karaketir16/NUC980DKxxYx_Development_Board/MPU.kicad_sch

## KiCad design MPU.kicad_sch (2023-03-14)

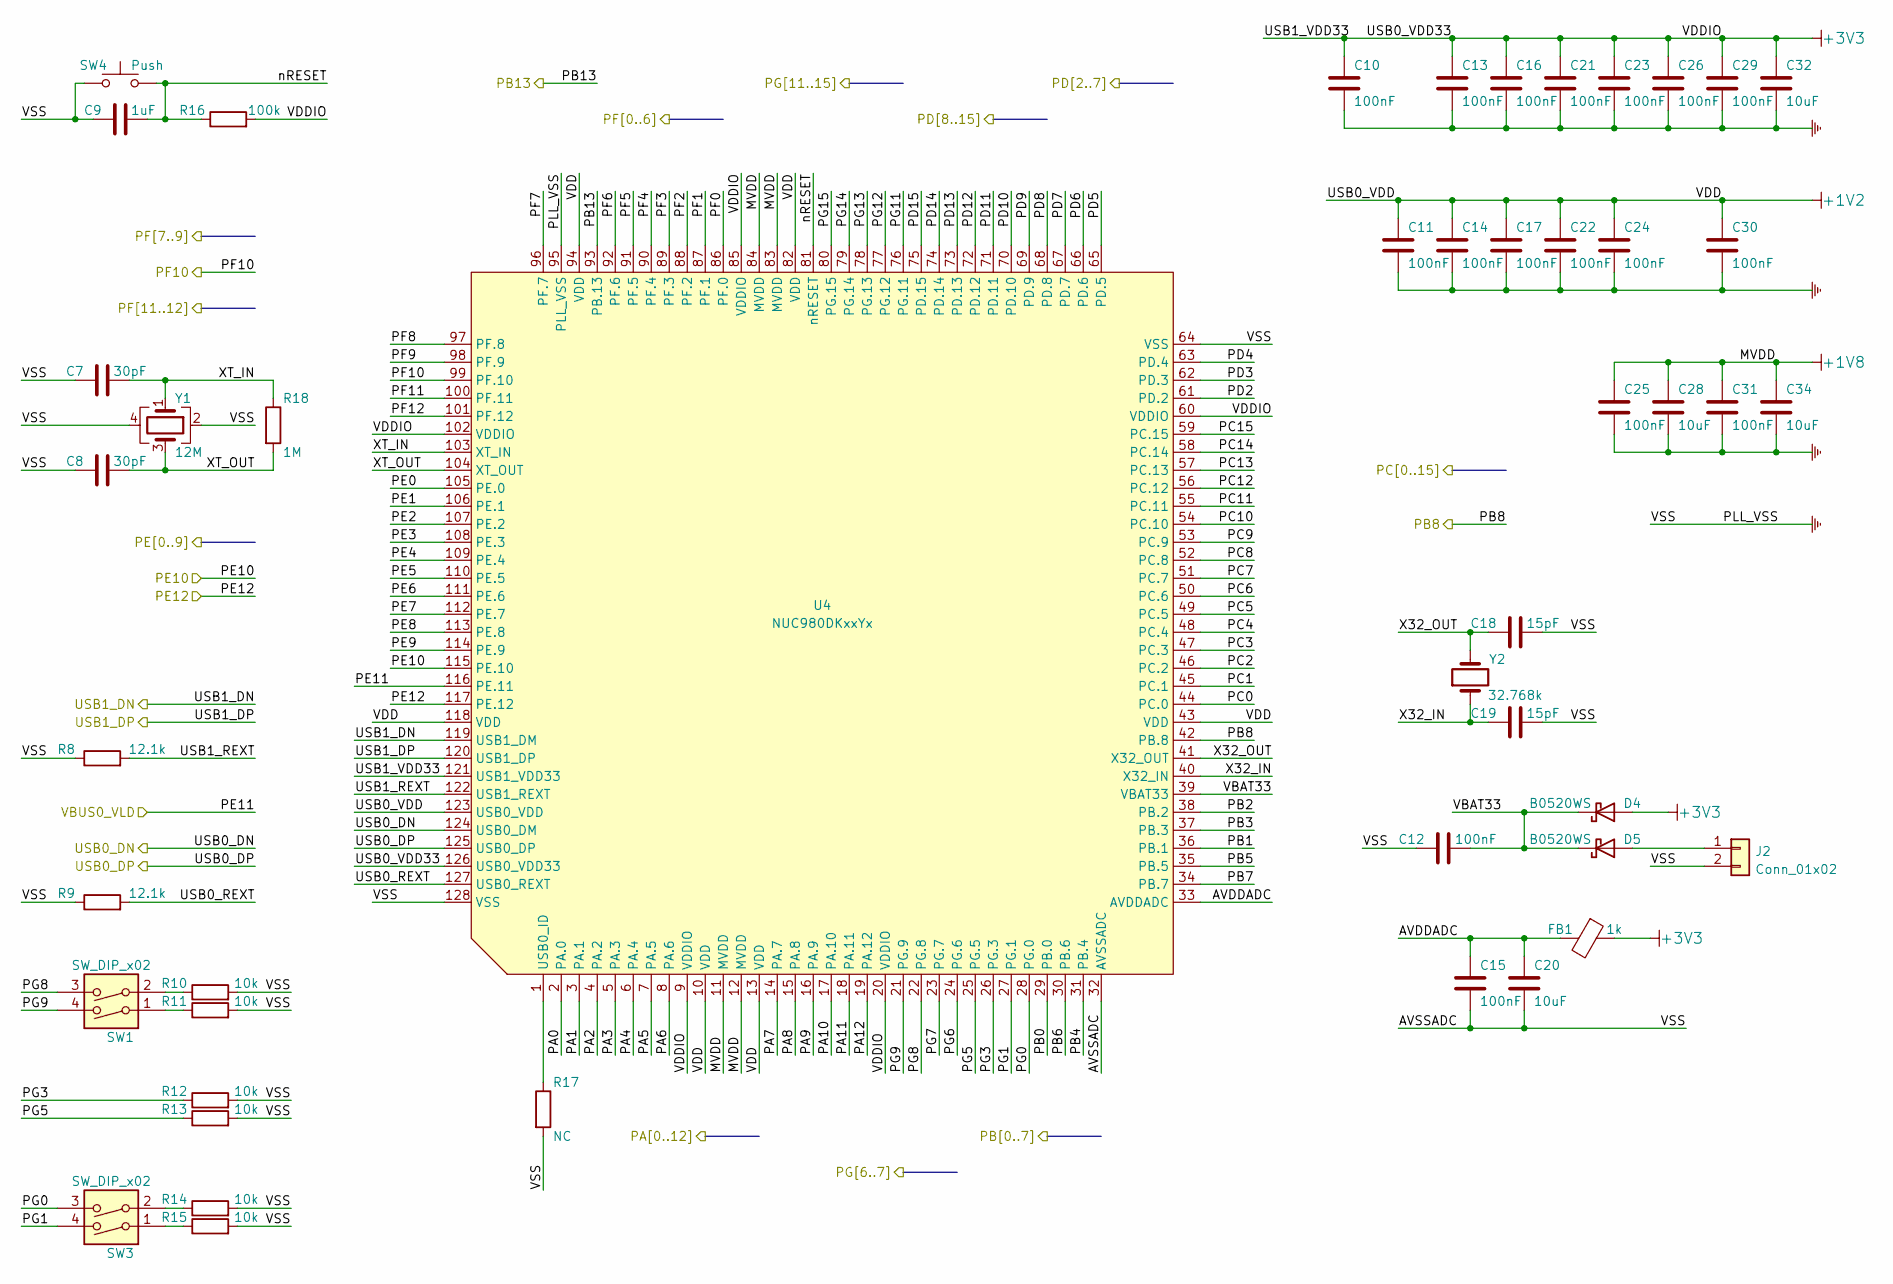
[picture p1: schematic MPU.kicad_sch]

Parts:
C7, C8: 30pF; C_0805_2012Metric_Pad1.18x1.45mm_HandSolder
C9: 1uF; C_0805_2012Metric_Pad1.18x1.45mm_HandSolder
C10, C11, C12, C13, C14, C15, C16, C17, C21, C22, C23, C24, C25, C26, C29, C30, C31: 100nF; C_0805_2012Metric_Pad1.18x1.45mm_HandSolder
C18, C19: 15pF; C_0805_2012Metric_Pad1.18x1.45mm_HandSolder
C20, C28, C32, C34: 10uF; C_0805_2012Metric_Pad1.18x1.45mm_HandSolder
D4, D5: B0520WS; D_SOD-323
FB1: 1k; L_0603_1608Metric
J2: Conn_01x02; PinHeader_1x02_P2.54mm_Vertical
R8, R9: 12.1k; R_0805_2012Metric_Pad1.20x1.40mm_HandSolder
R10, R11, R12, R13, R14, R15: 10k; R_0805_2012Metric_Pad1.20x1.40mm_HandSolder
R16: 100k; R_0805_2012Metric_Pad1.20x1.40mm_HandSolder
R17: NC; R_0805_2012Metric_Pad1.20x1.40mm_HandSolder
R18: 1M; R_0805_2012Metric_Pad1.20x1.40mm_HandSolder
SW1, SW3: SW_DIP_x02; SW_DIP_SPSTx02_Slide_9.78x7.26mm_W7.62mm_P2.54mm
SW4: Push; SW_SPST_CK_RS282G05A3
U4: NUC980DKxxYx; LQFP-128_14x14mm_P0.4mm
Y1: 12M; Crystal_SMD_3225-4Pin_3.2x2.5mm
Y2: 32.768k; Crystal_SMD_3215-2Pin_3.2x1.5mm

Connections:
+1V2: C11.1, C14.1, C17.1, C22.1, C24.1, C30.1, U4.10 (VDD), U4.13 (VDD), U4.43 (VDD), U4.82 (VDD), U4.94 (VDD), U4.118 (VDD), U4.123 (USB0_VDD)
+1V8: C25.1, C28.1, C31.1, C34.1, U4.11 (MVDD), U4.12 (MVDD), U4.83 (MVDD), U4.84 (MVDD)
+3V3: C10.1, C13.1, C16.1, C21.1, C23.1, C26.1, C29.1, C32.1, D4.2 (A), FB1.1, R16.2, U4.9 (VDDIO), U4.20 (VDDIO), U4.60 (VDDIO), U4.85 (VDDIO), U4.102 (VDDIO), U4.121 (USB1_VDD33), U4.126 (USB0_VDD33)
AVDDADC: C15.1, C20.1, FB1.2, U4.33 (AVDDADC)
GND: C7.1, C8.1, C9.1, C10.2, C11.2, C12.1, C13.2, C14.2, C15.2, C16.2, C17.2, C18.2, C19.2, C20.2, C21.2, C22.2, C23.2, C24.2, C25.2, C26.2, C28.2, C29.2, C30.2, C31.2, C32.2, C34.2, J2.2, R8.1, R9.1, R10.2, R11.2, R12.2, R13.2, R14.2, R15.2, R17.2, SW4.2, U4.32 (AVSSADC), U4.64 (VSS), U4.95 (PLL_VSS), U4.128 (VSS), Y1.2, Y1.4
unnamed: D5.2 (A), J2.1
unnamed: R10.1, SW1.2
unnamed: R11.1, SW1.1
unnamed: R14.1, SW3.2
unnamed: R15.1, SW3.1
unnamed: R17.1, U4.1 (USB0_ID)
PA0: U4.2 (PA.0)
PA1: U4.3 (PA.1)
PA2: U4.4 (PA.2)
PA3: U4.5 (PA.3)
PA4: U4.6 (PA.4)
PA5: U4.7 (PA.5)
PA6: U4.8 (PA.6)
PA7: U4.14 (PA.7)
PA8: U4.15 (PA.8)
PA9: U4.16 (PA.9)
PA10: U4.17 (PA.10)
PA11: U4.18 (PA.11)
PA12: U4.19 (PA.12)
PB0: U4.29 (PB.0)
PB1: U4.36 (PB.1)
PB2: U4.38 (PB.2)
PB3: U4.37 (PB.3)
PB4: U4.31 (PB.4)
PB5: U4.35 (PB.5)
PB6: U4.30 (PB.6)
PB7: U4.34 (PB.7)
PB8: U4.42 (PB.8)
PB13: U4.93 (PB.13)
PC0: U4.44 (PC.0)
PC1: U4.45 (PC.1)
PC2: U4.46 (PC.2)
PC3: U4.47 (PC.3)
PC4: U4.48 (PC.4)
PC5: U4.49 (PC.5)
PC6: U4.50 (PC.6)
PC7: U4.51 (PC.7)
PC8: U4.52 (PC.8)
PC9: U4.53 (PC.9)
PC10: U4.54 (PC.10)
PC11: U4.55 (PC.11)
PC12: U4.56 (PC.12)
PC13: U4.57 (PC.13)
PC14: U4.58 (PC.14)
PC15: U4.59 (PC.15)
PD2: U4.61 (PD.2)
PD3: U4.62 (PD.3)
PD4: U4.63 (PD.4)
PD5: U4.65 (PD.5)
PD6: U4.66 (PD.6)
PD7: U4.67 (PD.7)
PD8: U4.68 (PD.8)
PD9: U4.69 (PD.9)
PD10: U4.70 (PD.10)
PD11: U4.71 (PD.11)
PD12: U4.72 (PD.12)
PD13: U4.73 (PD.13)
PD14: U4.74 (PD.14)
PD15: U4.75 (PD.15)
PE0: U4.105 (PE.0)
PE1: U4.106 (PE.1)
PE2: U4.107 (PE.2)
PE3: U4.108 (PE.3)
PE4: U4.109 (PE.4)
PE5: U4.110 (PE.5)
PE6: U4.111 (PE.6)
PE7: U4.112 (PE.7)
PE8: U4.113 (PE.8)
PE9: U4.114 (PE.9)
PE10: U4.115 (PE.10)
PE11: U4.116 (PE.11)
PE12: U4.117 (PE.12)
PF0: U4.86 (PF.0)
PF1: U4.87 (PF.1)
PF2: U4.88 (PF.2)
PF3: U4.89 (PF.3)
PF4: U4.90 (PF.4)
PF5: U4.91 (PF.5)
PF6: U4.92 (PF.6)
PF7: U4.96 (PF.7)
PF8: U4.97 (PF.8)
PF9: U4.98 (PF.9)
PF10: U4.99 (PF.10)
PF11: U4.100 (PF.11)
PF12: U4.101 (PF.12)
PG0: SW3.3, U4.28 (PG.0)
PG1: SW3.4, U4.27 (PG.1)
PG3: R12.1, U4.26 (PG.3)
PG5: R13.1, U4.25 (PG.5)
PG6: U4.24 (PG.6)
PG7: U4.23 (PG.7)
PG8: SW1.3, U4.22 (PG.8)
PG9: SW1.4, U4.21 (PG.9)
PG11: U4.76 (PG.11)
PG12: U4.77 (PG.12)
PG13: U4.78 (PG.13)
PG14: U4.79 (PG.14)
PG15: U4.80 (PG.15)
USB0_DN: U4.124 (USB0_DM)
USB0_DP: U4.125 (USB0_DP)
USB0_REXT: R9.2, U4.127 (USB0_REXT)
USB1_DN: U4.119 (USB1_DM)
USB1_DP: U4.120 (USB1_DP)
USB1_REXT: R8.2, U4.122 (USB1_REXT)
VBAT33: C12.2, D4.1 (K), D5.1 (K), U4.39 (VBAT33)
X32_IN: C19.1, U4.40 (X32_IN), Y2.1
X32_OUT: C18.1, U4.41 (X32_OUT), Y2.2
XT_IN: C7.2, R18.1, U4.103 (XT_IN), Y1.1
XT_OUT: C8.2, R18.2, U4.104 (XT_OUT), Y1.3
nRESET: C9.2, R16.1, SW4.1, U4.81 (nRESET)
