karaketir16/NUC980DKxxYx_Development_Board/Power.kicad_sch

## KiCad design Power.kicad_sch (2023-03-14)

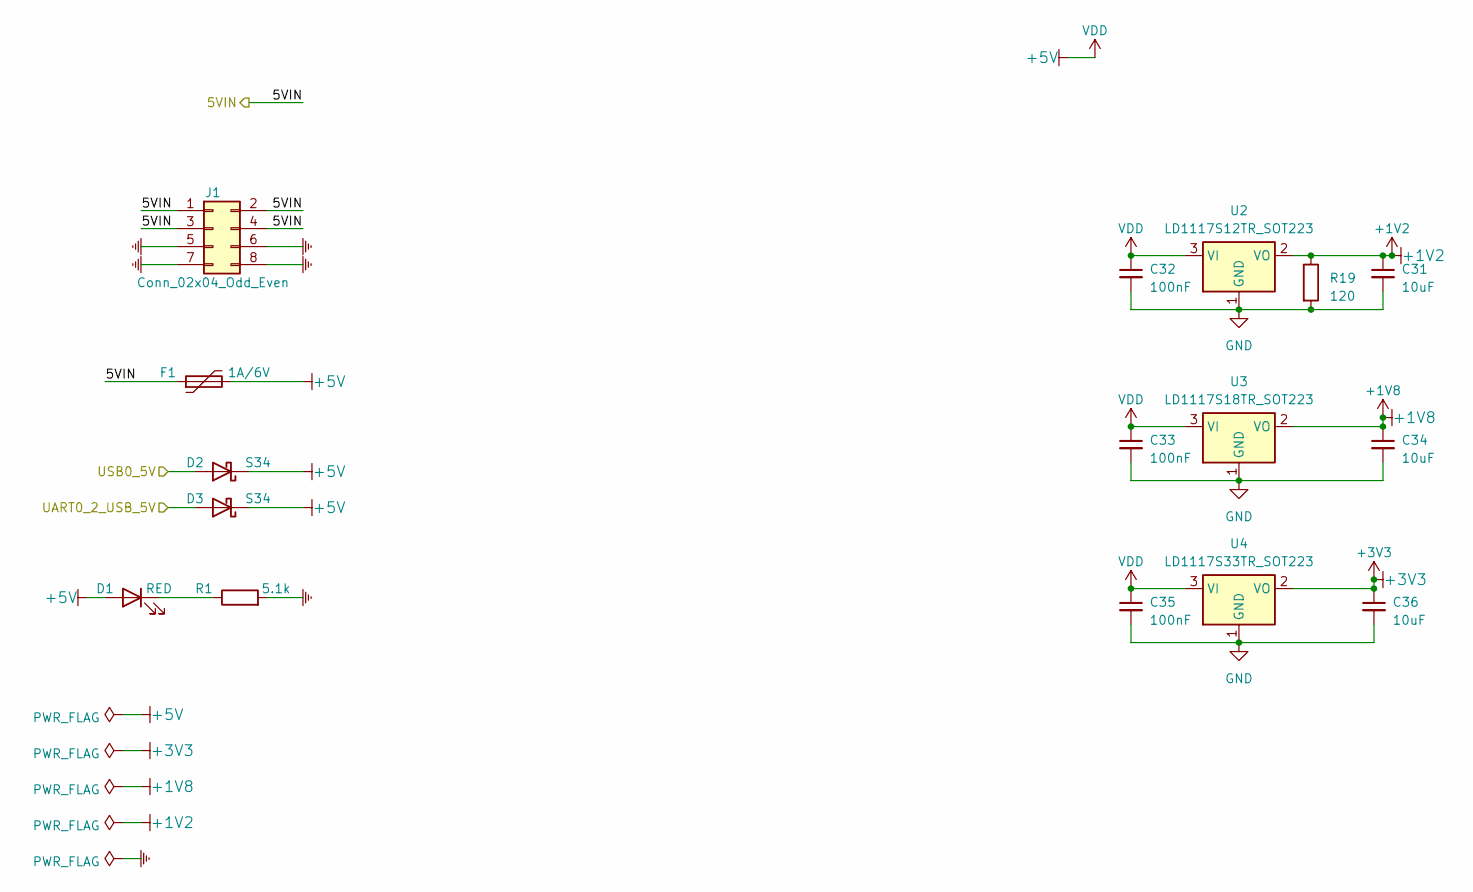
[picture p2: schematic Power.kicad_sch]

Parts:
C31, C34, C36: 10uF; C_0603_1608Metric_Pad1.08x0.95mm_HandSolder
C32, C33, C35: 100nF; C_0603_1608Metric_Pad1.08x0.95mm_HandSolder
D1: RED; LED_0603_1608Metric
D2, D3: S34; D_SOD-123F
F1: 1A/6V; Fuse_1206_3216Metric_Pad1.42x1.75mm_HandSolder
J1: Conn_02x04_Odd_Even; PinHeader_2x04_P2.54mm_Vertical
R1: 5.1k; R_0805_2012Metric_Pad1.20x1.40mm_HandSolder
R19: 120; R_0603_1608Metric_Pad0.98x0.95mm_HandSolder
U2: LD1117S12TR_SOT223; SOT-223-3_TabPin2
U3: LD1117S18TR_SOT223; SOT-223-3_TabPin2
U4: LD1117S33TR_SOT223; SOT-223-3_TabPin2

Connections:
5VIN: F1.1, J1.1, J1.2, J1.3, J1.4
+1V2: C31.1, R19.1, U2.2 (VO)
+1V8: C34.1, U3.2 (VO)
+3V3: C36.1, U4.2 (VO)
+5V: C32.1, C33.1, C35.1, D1.2 (A), D2.1 (K), D3.1 (K), F1.2, U2.3 (VI), U3.3 (VI), U4.3 (VI)
GND: C31.2, C32.2, C33.2, C34.2, C35.2, C36.2, J1.5, J1.6, J1.7, J1.8, R1.2, R19.2, U2.1 (GND), U3.1 (GND), U4.1 (GND)
unnamed: D1.1 (K), R1.1
UART0_2_USB_5V: D3.2 (A)
USB0_5V: D2.2 (A)
