karaketir16/NUC980DKxxYx_Development_Board/RMII_ETH.kicad_sch

## KiCad design RMII_ETH.kicad_sch (2023-03-14)

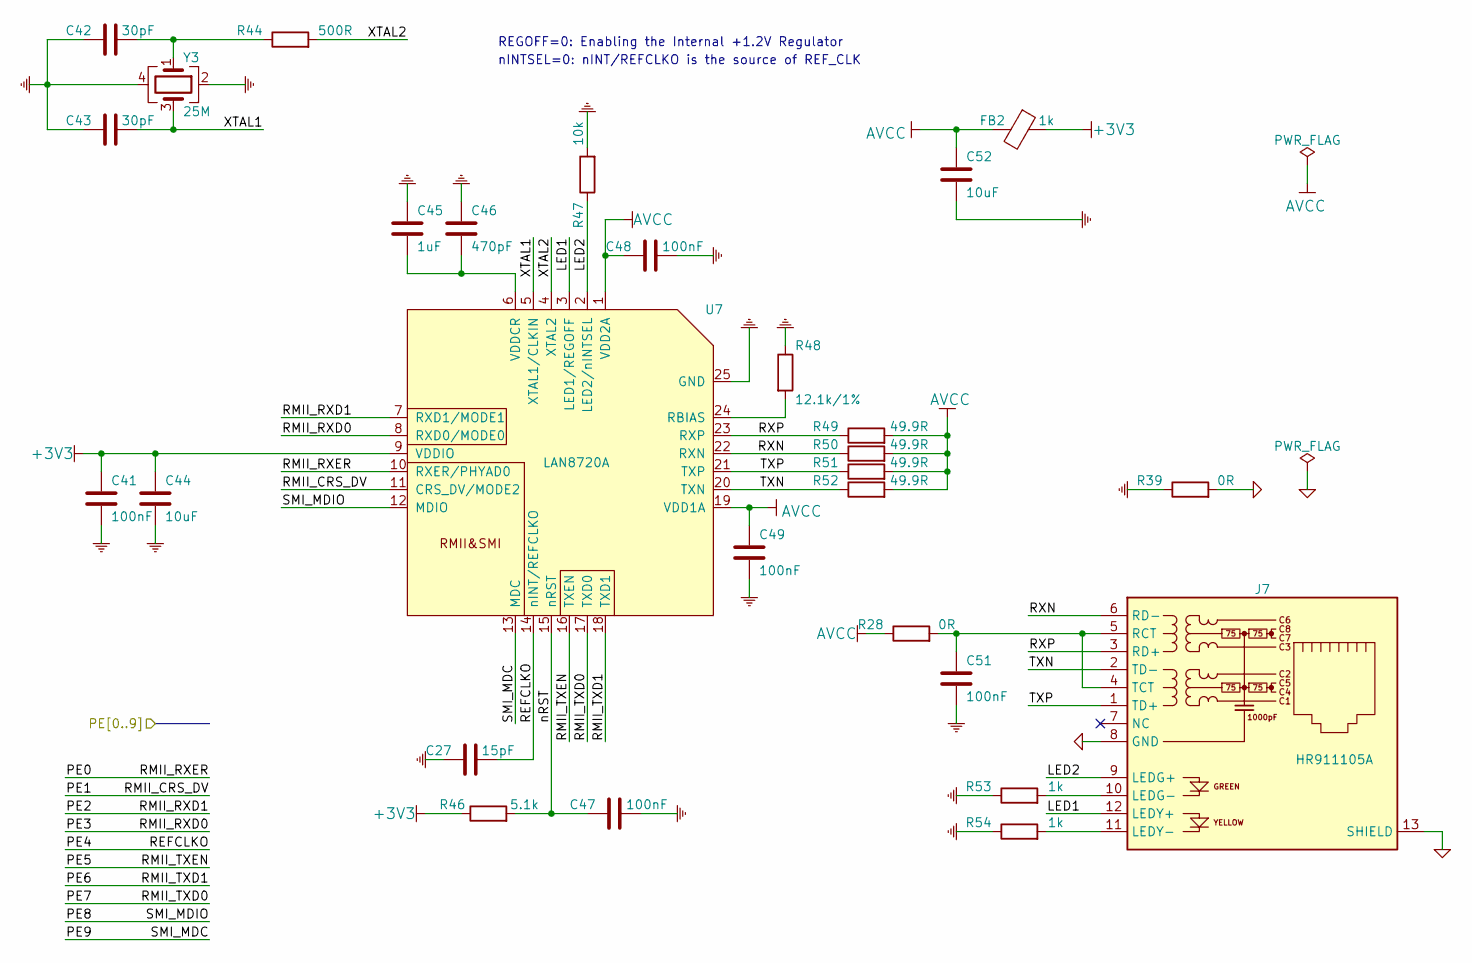
[picture p3: schematic RMII_ETH.kicad_sch]

Parts:
C27: 15pF; C_0805_2012Metric_Pad1.18x1.45mm_HandSolder
C41, C47, C48, C49, C51: 100nF; C_0805_2012Metric_Pad1.18x1.45mm_HandSolder
C42, C43: 30pF; C_0805_2012Metric_Pad1.18x1.45mm_HandSolder
C44, C52: 10uF; C_0805_2012Metric_Pad1.18x1.45mm_HandSolder
C45: 1uF; C_0805_2012Metric_Pad1.18x1.45mm_HandSolder
C46: 470pF; C_0805_2012Metric_Pad1.18x1.45mm_HandSolder
FB2: 1k; L_0603_1608Metric
J7: HR911105A; RJ45_Hanrun_HR911105A
R28, R39: 0R; R_0805_2012Metric_Pad1.20x1.40mm_HandSolder
R44: 500R; R_0805_2012Metric_Pad1.20x1.40mm_HandSolder
R46: 5.1k; R_0805_2012Metric_Pad1.20x1.40mm_HandSolder
R47: 10k; R_0805_2012Metric_Pad1.20x1.40mm_HandSolder
R48: 12.1k/1%; R_0805_2012Metric_Pad1.20x1.40mm_HandSolder
R49, R50, R51, R52: 49.9R; R_0805_2012Metric_Pad1.20x1.40mm_HandSolder
R53, R54: 1k; R_0805_2012Metric_Pad1.20x1.40mm_HandSolder
U7: LAN8720A; VQFN-24-1EP_4x4mm_P0.5mm_EP2.45x2.45mm
Y3: 25M; Crystal_SMD_3225-4Pin_3.2x2.5mm

Connections:
+3V3: C41.1, C44.1, FB2.1, R46.1, U7.9 (VDDIO)
AVCC: C48.1, C49.1, C52.1, FB2.2, R28.1, R49.2, R50.2, R51.2, R52.2, U7.1 (VDD2A), U7.19 (VDD1A)
GND: C27.1, C41.2, C42.1, C43.1, C44.2, C45.1, C46.1, C47.2, C48.2, C49.2, C51.2, C52.2, R39.1, R47.2, R48.1, R53.1, R54.1, U7.25 (GND), Y3.2, Y3.4
GNDA: J7.8 (GND), J7.13 (SHIELD), R39.2
LED1: J7.12 (LEDY+), U7.3 (LED1/REGOFF)
LED2: J7.9 (LEDG+), R47.1, U7.2 (LED2/nINTSEL)
unnamed: C42.2, R44.1, Y3.1
unnamed: C45.2, C46.2, U7.6 (VDDCR)
unnamed: C51.1, J7.4 (TCT), J7.5 (RCT), R28.2
unnamed: J7.10 (LEDG-), R53.2
unnamed: J7.11 (LEDY-), R54.2
unnamed: R48.2, U7.24 (RBIAS)
PE0: U7.10 (RXER/PHYAD0)
PE1: U7.11 (CRS_DV/MODE2)
PE2: U7.7 (RXD1/MODE1)
PE3: U7.8 (RXD0/MODE0)
PE4: C27.2, U7.14 (nINT/REFCLKO)
PE5: U7.16 (TXEN)
PE6: U7.18 (TXD1)
PE7: U7.17 (TXD0)
PE8: U7.12 (MDIO)
PE9: U7.13 (MDC)
RXN: J7.6 (RD-), R50.1, U7.22 (RXN)
RXP: J7.3 (RD+), R49.1, U7.23 (RXP)
TXN: J7.2 (TD-), R52.1, U7.20 (TXN)
TXP: J7.1 (TD+), R51.1, U7.21 (TXP)
XTAL1: C43.2, U7.5 (XTAL1/CLKIN), Y3.3
XTAL2: R44.2, U7.4 (XTAL2)
nRST: C47.1, R46.2, U7.15 (nRST)

Notes on the sheet:
REGOFF=0: Enabling the Internal +1.2V Regulator
nINTSEL=0: nINT/REFCLKO is the source of REF_CLK
