karaketir16/NUC980DKxxYx_Development_Board/Remaining_IO.kicad_sch

## KiCad design Remaining_IO.kicad_sch (2023-03-14)

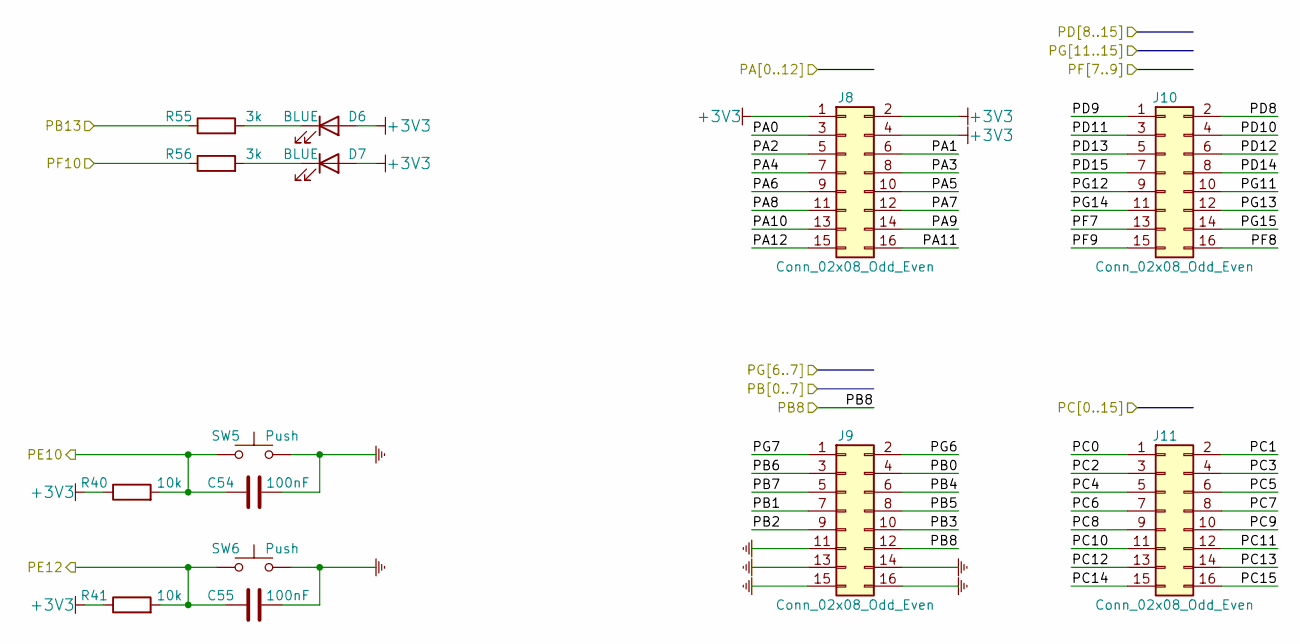
[picture p4: schematic Remaining_IO.kicad_sch]

Parts:
C54, C55: 100nF; C_0805_2012Metric_Pad1.18x1.45mm_HandSolder
D6, D7: BLUE; LED_0603_1608Metric
J8, J9, J10, J11: Conn_02x08_Odd_Even; PinHeader_2x08_P2.54mm_Vertical
R40, R41: 10k; R_0805_2012Metric_Pad1.20x1.40mm_HandSolder
R55, R56: 3k; R_0805_2012Metric_Pad1.20x1.40mm_HandSolder
SW5, SW6: Push; SW_SPST_CK_RS282G05A3

Connections:
+3V3: D6.2 (A), D7.2 (A), J8.1, J8.2, J8.4, R40.1, R41.1
GND: C54.2, C55.2, J9.11, J9.13, J9.14, J9.15, J9.16, SW5.1, SW6.1
unnamed: D6.1 (K), R55.2
unnamed: D7.1 (K), R56.2
PA0: J8.3
PA1: J8.6
PA2: J8.5
PA3: J8.8
PA4: J8.7
PA5: J8.10
PA6: J8.9
PA7: J8.12
PA8: J8.11
PA9: J8.14
PA10: J8.13
PA11: J8.16
PA12: J8.15
PB0: J9.4
PB1: J9.7
PB2: J9.9
PB3: J9.10
PB4: J9.6
PB5: J9.8
PB6: J9.3
PB7: J9.5
PB8: J9.12
PB13: R55.1
PC0: J11.1
PC1: J11.2
PC2: J11.3
PC3: J11.4
PC4: J11.5
PC5: J11.6
PC6: J11.7
PC7: J11.8
PC8: J11.9
PC9: J11.10
PC10: J11.11
PC11: J11.12
PC12: J11.13
PC13: J11.14
PC14: J11.15
PC15: J11.16
PD8: J10.2
PD9: J10.1
PD10: J10.4
PD11: J10.3
PD12: J10.6
PD13: J10.5
PD14: J10.8
PD15: J10.7
PE10: C54.1, R40.2, SW5.2
PE12: C55.1, R41.2, SW6.2
PF7: J10.13
PF8: J10.16
PF9: J10.15
PF10: R56.1
PG6: J9.2
PG7: J9.1
PG11: J10.10
PG12: J10.9
PG13: J10.12
PG14: J10.11
PG15: J10.14
