karaketir16/NUC980DKxxYx_Development_Board/SD_Card.kicad_sch

## KiCad design SD_Card.kicad_sch (2023-03-14)

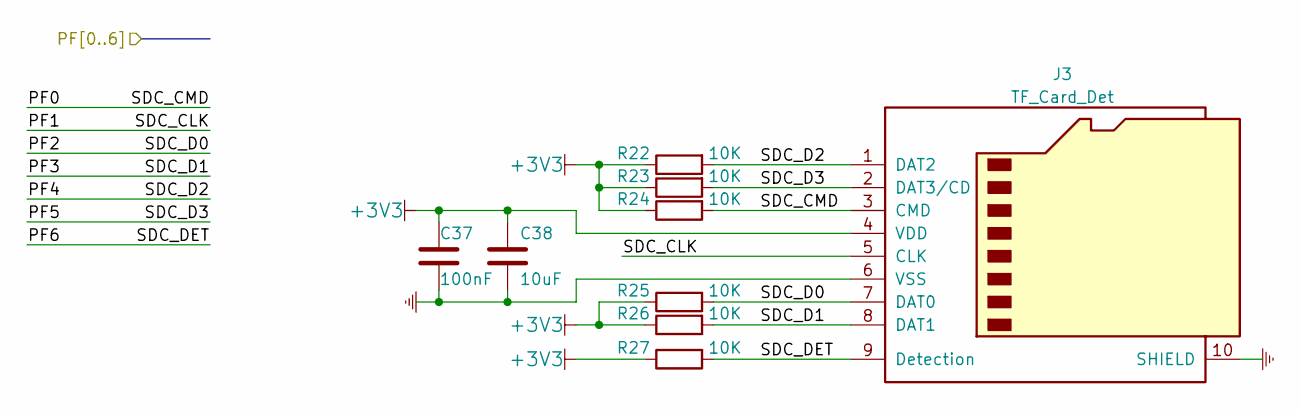
[picture p5: schematic SD_Card.kicad_sch]

Parts:
C37: 100nF; C_0805_2012Metric_Pad1.18x1.45mm_HandSolder
C38: 10uF; C_0805_2012Metric_Pad1.18x1.45mm_HandSolder
J3: TF_Card_Det; MicroSD_2908-05WB-MG
R22, R23, R24, R25, R26, R27: 10K; R_0805_2012Metric_Pad1.20x1.40mm_HandSolder

Connections:
+3V3: C37.1, C38.1, J3.4 (VDD), R22.1, R23.1, R24.1, R25.1, R26.1, R27.1
GND: C37.2, C38.2, J3.6 (VSS), J3.10 (SHIELD)
PF0: J3.3 (CMD), R24.2
PF1: J3.5 (CLK)
PF2: J3.7 (DAT0), R25.2
PF3: J3.8 (DAT1), R26.2
PF4: J3.1 (DAT2), R22.2
PF5: J3.2 (DAT3/CD), R23.2
PF6: J3.9 (Detection), R27.2
