karaketir16/NUC980DKxxYx_Development_Board/SPI_Flash.kicad_sch

## KiCad design SPI_Flash.kicad_sch (2023-03-14)

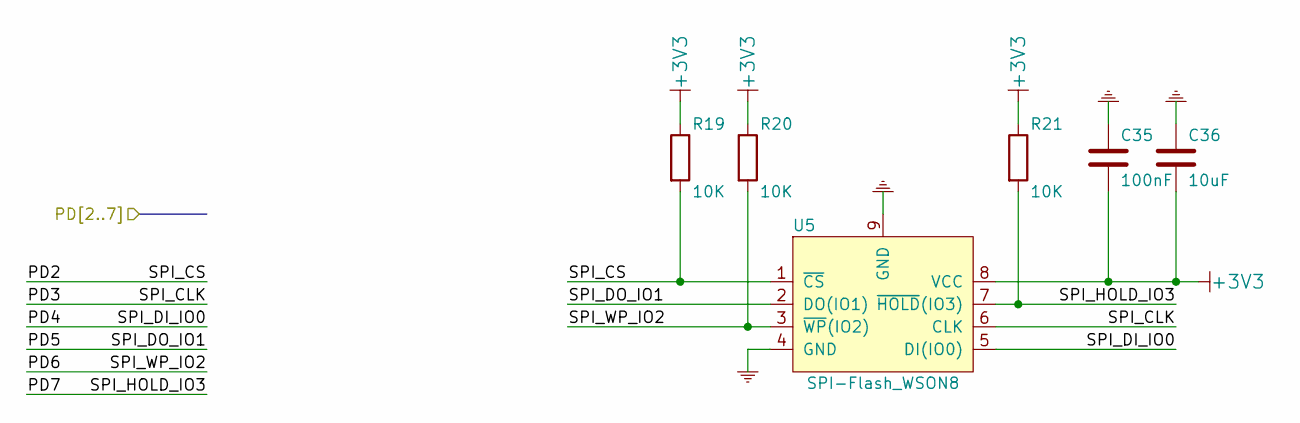
[picture p6: schematic SPI_Flash.kicad_sch]

Parts:
C35: 100nF; C_0805_2012Metric_Pad1.18x1.45mm_HandSolder
C36: 10uF; C_0805_2012Metric_Pad1.18x1.45mm_HandSolder
R19, R20, R21: 10K; R_0805_2012Metric_Pad1.20x1.40mm_HandSolder
U5: SPI-Flash_WSON8; WSON-8-1EP_8x6mm_P1.27mm_EP3.4x4.3mm

Connections:
+3V3: C35.2, C36.2, R19.1, R20.1, R21.1, U5.8 (VCC)
GND: C35.1, C36.1, U5.4 (GND), U5.9 (GND)
PD2: R19.2, U5.1 (~CS)
PD3: U5.6 (CLK)
PD4: U5.5 (DI(IO0))
PD5: U5.2 (DO(IO1))
PD6: R20.2, U5.3 (~WP(IO2))
PD7: R21.2, U5.7 (~HOLD(IO3))
