karaketir16/NUC980DKxxYx_Development_Board/UART0_2_USB.kicad_sch

## KiCad design UART0_2_USB.kicad_sch (2023-03-14)

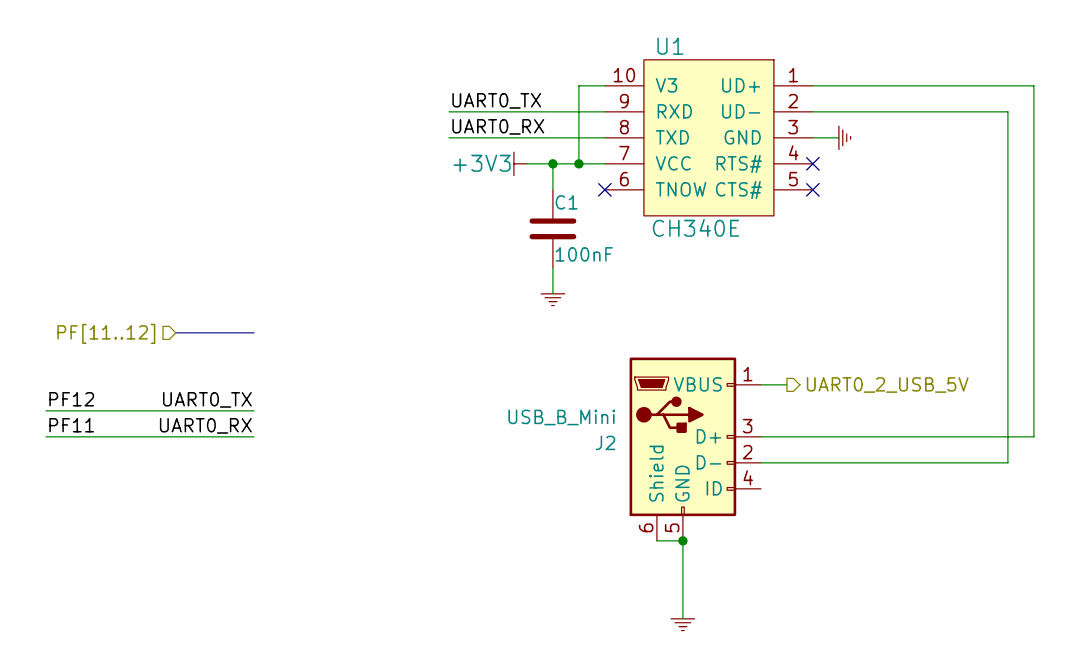
[picture p7: schematic UART0_2_USB.kicad_sch]

Parts:
C1: 100nF; C_0805_2012Metric_Pad1.18x1.45mm_HandSolder
J2: USB_B_Mini; USB_Mini_B_Female_690-005-299-043
U1: CH340E; MSOP-10_3x3mm_P0.5mm

Connections:
+3V3: C1.1, U1.7 (VCC), U1.10 (V3)
GND: C1.2, J2.5 (GND), J2.6 (Shield), U1.3 (GND)
unnamed: J2.2 (D-), U1.2 (UD-)
unnamed: J2.3 (D+), U1.1 (UD+)
PF11: U1.8 (TXD)
PF12: U1.9 (RXD)
UART0_2_USB_5V: J2.1 (VBUS)
