karaketir16/NUC980DKxxYx_Development_Board/USB.kicad_sch

## KiCad design USB.kicad_sch (2023-03-14)

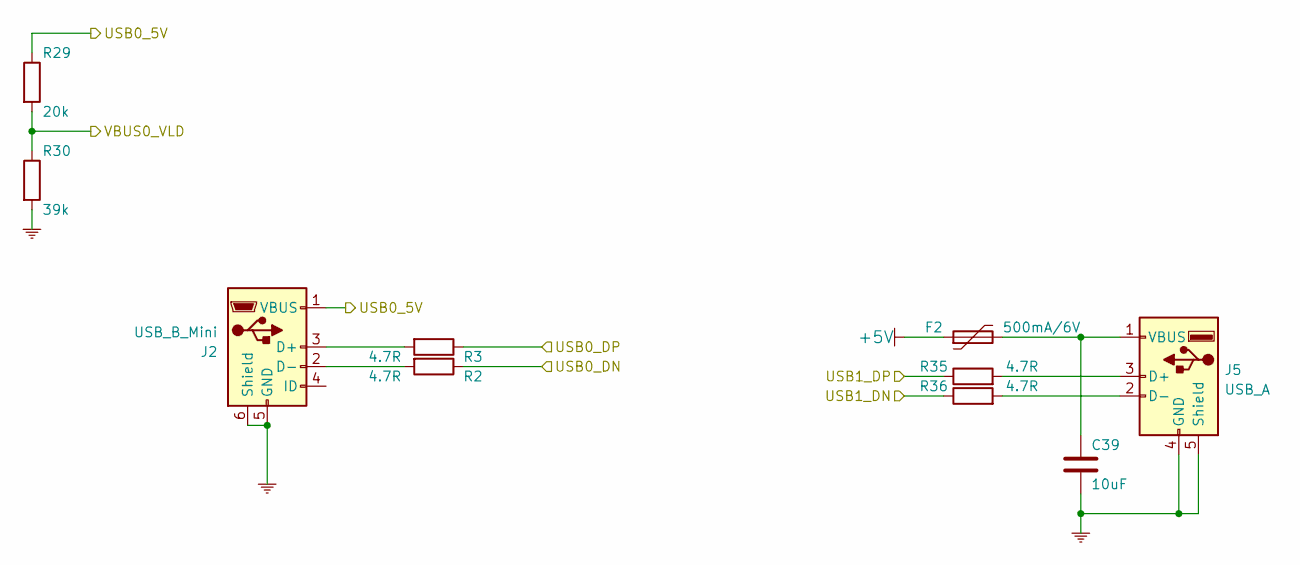
[picture p8: schematic USB.kicad_sch]

Parts:
C39: 10uF; C_0805_2012Metric_Pad1.18x1.45mm_HandSolder
F2: 500mA/6V; Fuse_1206_3216Metric_Pad1.42x1.75mm_HandSolder
J2: USB_B_Mini; USB_Mini_B_Female_690-005-299-043
J5: USB_A; USB_A_Female_UE27AC54100
R2, R3, R35, R36: 4.7R; R_0805_2012Metric_Pad1.20x1.40mm_HandSolder
R29: 20k; R_0805_2012Metric_Pad1.20x1.40mm_HandSolder
R30: 39k; R_0805_2012Metric_Pad1.20x1.40mm_HandSolder

Connections:
+5V: F2.1
GND: C39.2, J2.5 (GND), J2.6 (Shield), J5.4 (GND), J5.5 (Shield), R30.2
unnamed: C39.1, F2.2, J5.1 (VBUS)
unnamed: J2.2 (D-), R2.2
unnamed: J2.3 (D+), R3.2
unnamed: J5.2 (D-), R36.2
unnamed: J5.3 (D+), R35.2
USB0_5V: J2.1 (VBUS), R29.1
USB0_DN: R2.1
USB0_DP: R3.1
USB1_DN: R36.1
USB1_DP: R35.1
VBUS0_VLD: R29.2, R30.1
