karaketir16/NUC980DKxxYx_Development_Board/(commit log)

2023-03-14 update version KiCAD
    [MPU.kicad_sch, NUC980DKxxYx_Development_Board.kicad_pcb, NUC980DKxxYx_Development_Board.kicad_sch, Power.kicad_sch, RMII_ETH.kicad_sch, Remaining_IO.kicad_sch, SD_Card.kicad_sch, SPI_Flash.kicad_sch]
2023-03-14 remove pcb
    [NUC980DKxxYx_Development_Board.kicad_pcb]
2023-03-14 update schematic and footprints
    [MPU.kicad_sch, Power.kicad_sch, RMII_ETH.kicad_sch, Remaining_IO.kicad_sch, SD_Card.kicad_sch, SPI_Flash.kicad_sch, UART0_2_USB.kicad_sch, USB.kicad_sch]
